ajahidny-crypto/Jansen-linkage/Jansen-linkage.stl

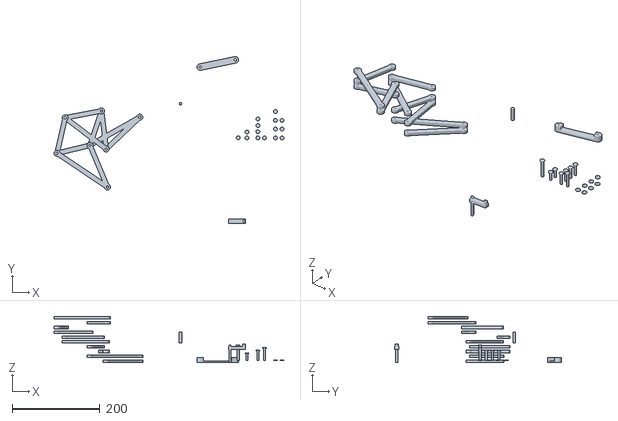
[picture p4: CAD file, 2026-10-30]
Jansen-linkage.stl
524.4 x 380.5 x 105.0
